astroelectronica/AE01.07.50.100/pcb/captures/AE01.07.50.100_3D_FRONT.png

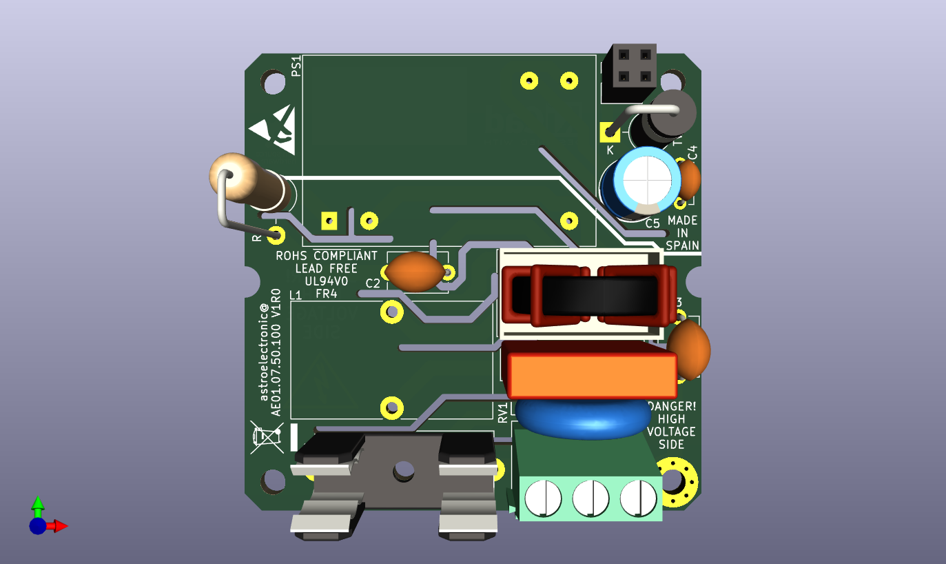
pcb/captures/AE01.07.50.100_3D_FRONT.png
