astroelectronica/AE01.07.50.100/pcb/captures/AE01.07.50.100_3D_BACK.png

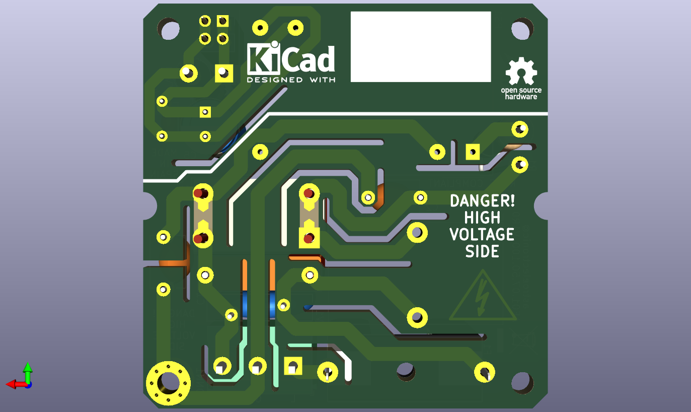
pcb/captures/AE01.07.50.100_3D_BACK.png
