astroelectronica/AE01.07.50.100/pcb/AE01.07.50.100_sch.pdf

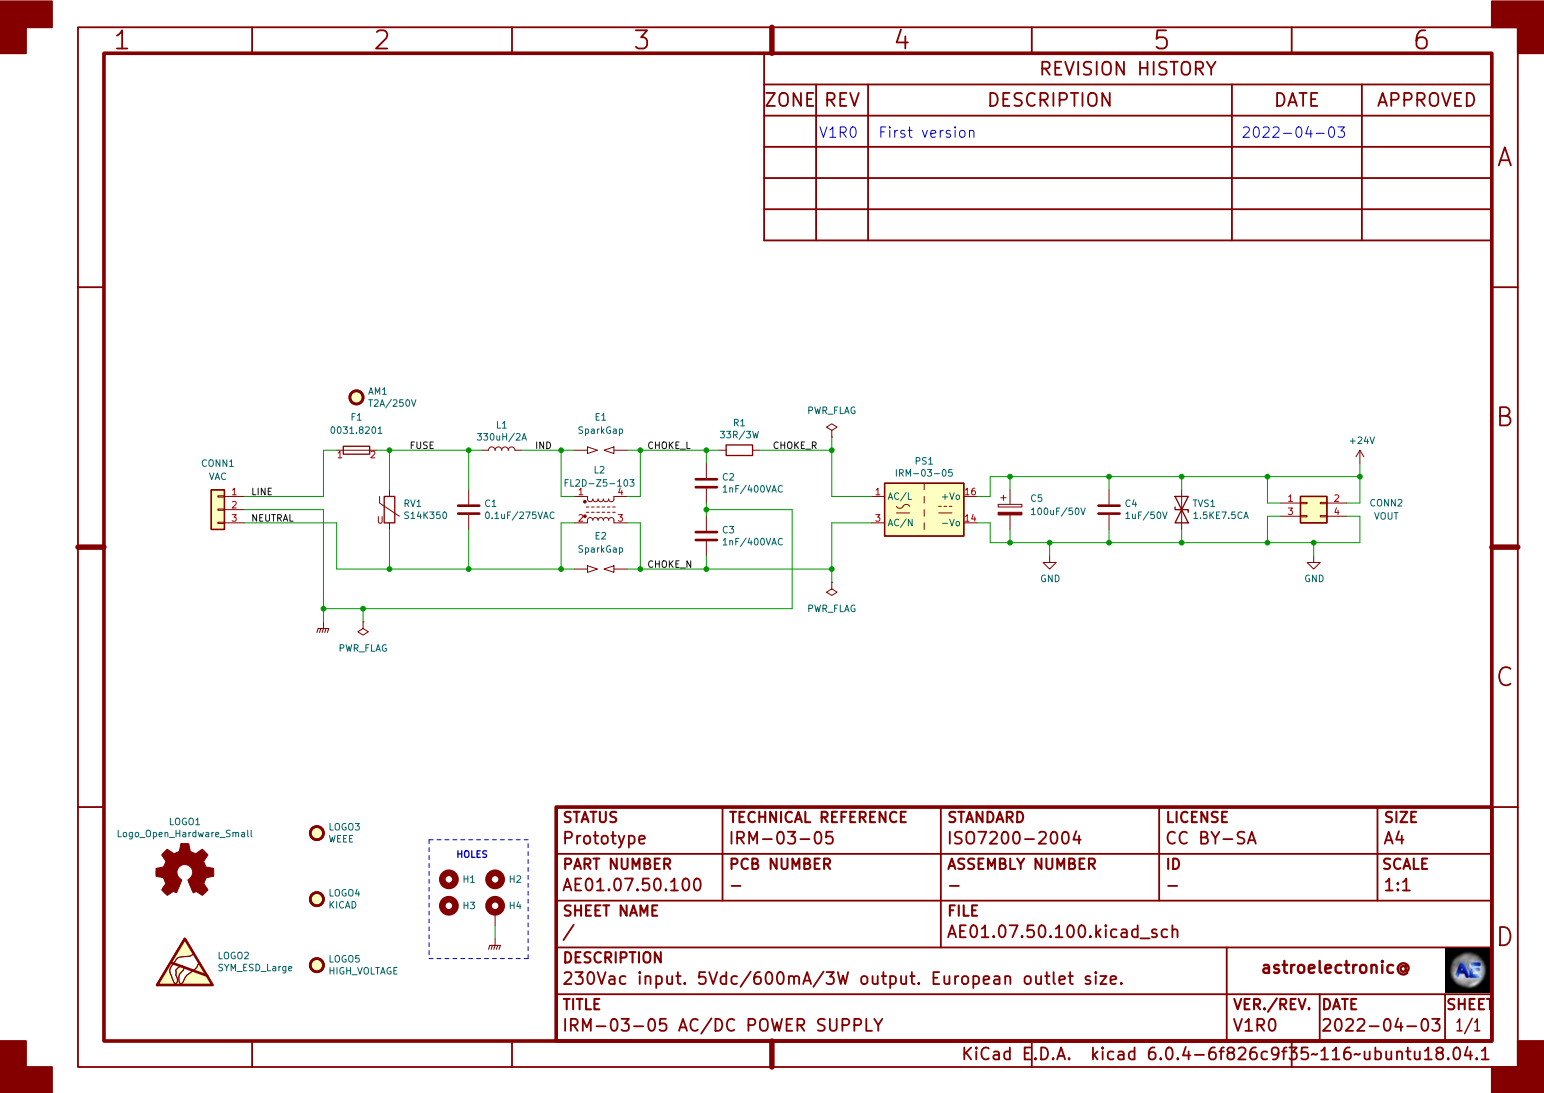
[picture p3: page 1]

Prototype | IRM-03-05 | | CC BY-SA
PART NUMBER | PCB NUMBER | ASSEMBLY NUMBER | ID | 1:1

DESCRIPTION

230Vac input. 5Vdc/600mA/3W output. European outlet size.
TITLE
IRM-03-05 AC/DC POWER SUPPLY
