astroelectronica/AE01.07.50.100/pcb/layers_pdf/AE01.07.50.100-User_Comments.pdf

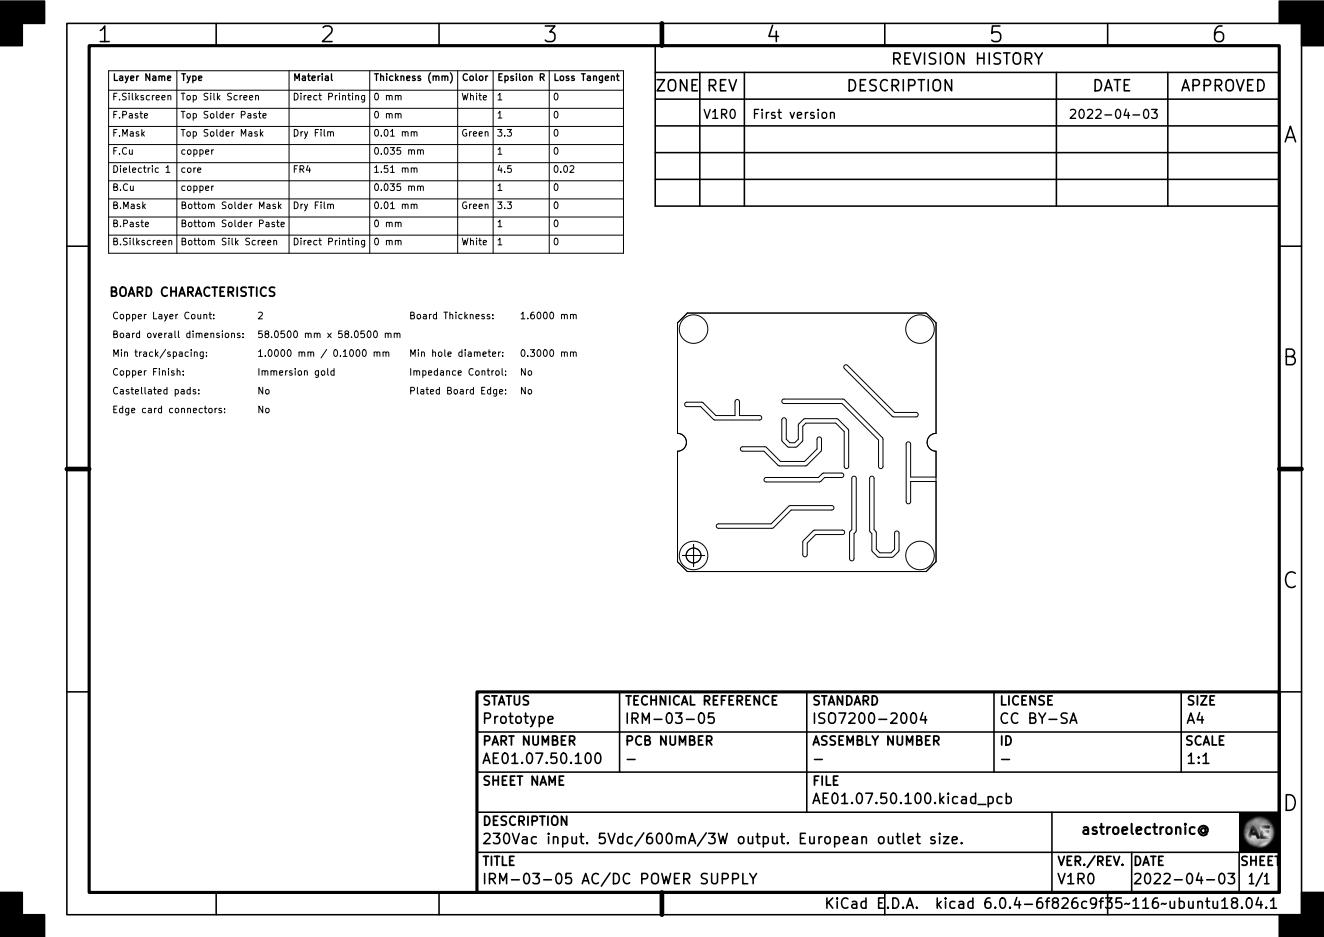
[picture p4: page 1]

0 Board overall dimensions: Type
2 F.Silkscreen BOARD CHARACTERISTICS

copper Top Solder Paste | | Material Dry Film | Thickness (mm) copper 0.01 mm | White F.Paste White Layer Name Green Green | 1 Dry Film 3.3 1 B.Mask | 0

0 mm | | 1 Top Silk Screen | 0.02 Color

core | | | 1.51 mm

Min hole diameter: 0.035 mm

0.01 mm
0 mm | 1 | 0

Prototype | IRM-03-05 | | CC BY-SA
PART NUMBER | PCB NUMBER | ASSEMBLY NUMBER | ID | 1:1

DESCRIPTION

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
