astroelectronica/AE01.07.50.100/pcb/pcb_mount/AE01.07.50.100_pcb_dim.pdf

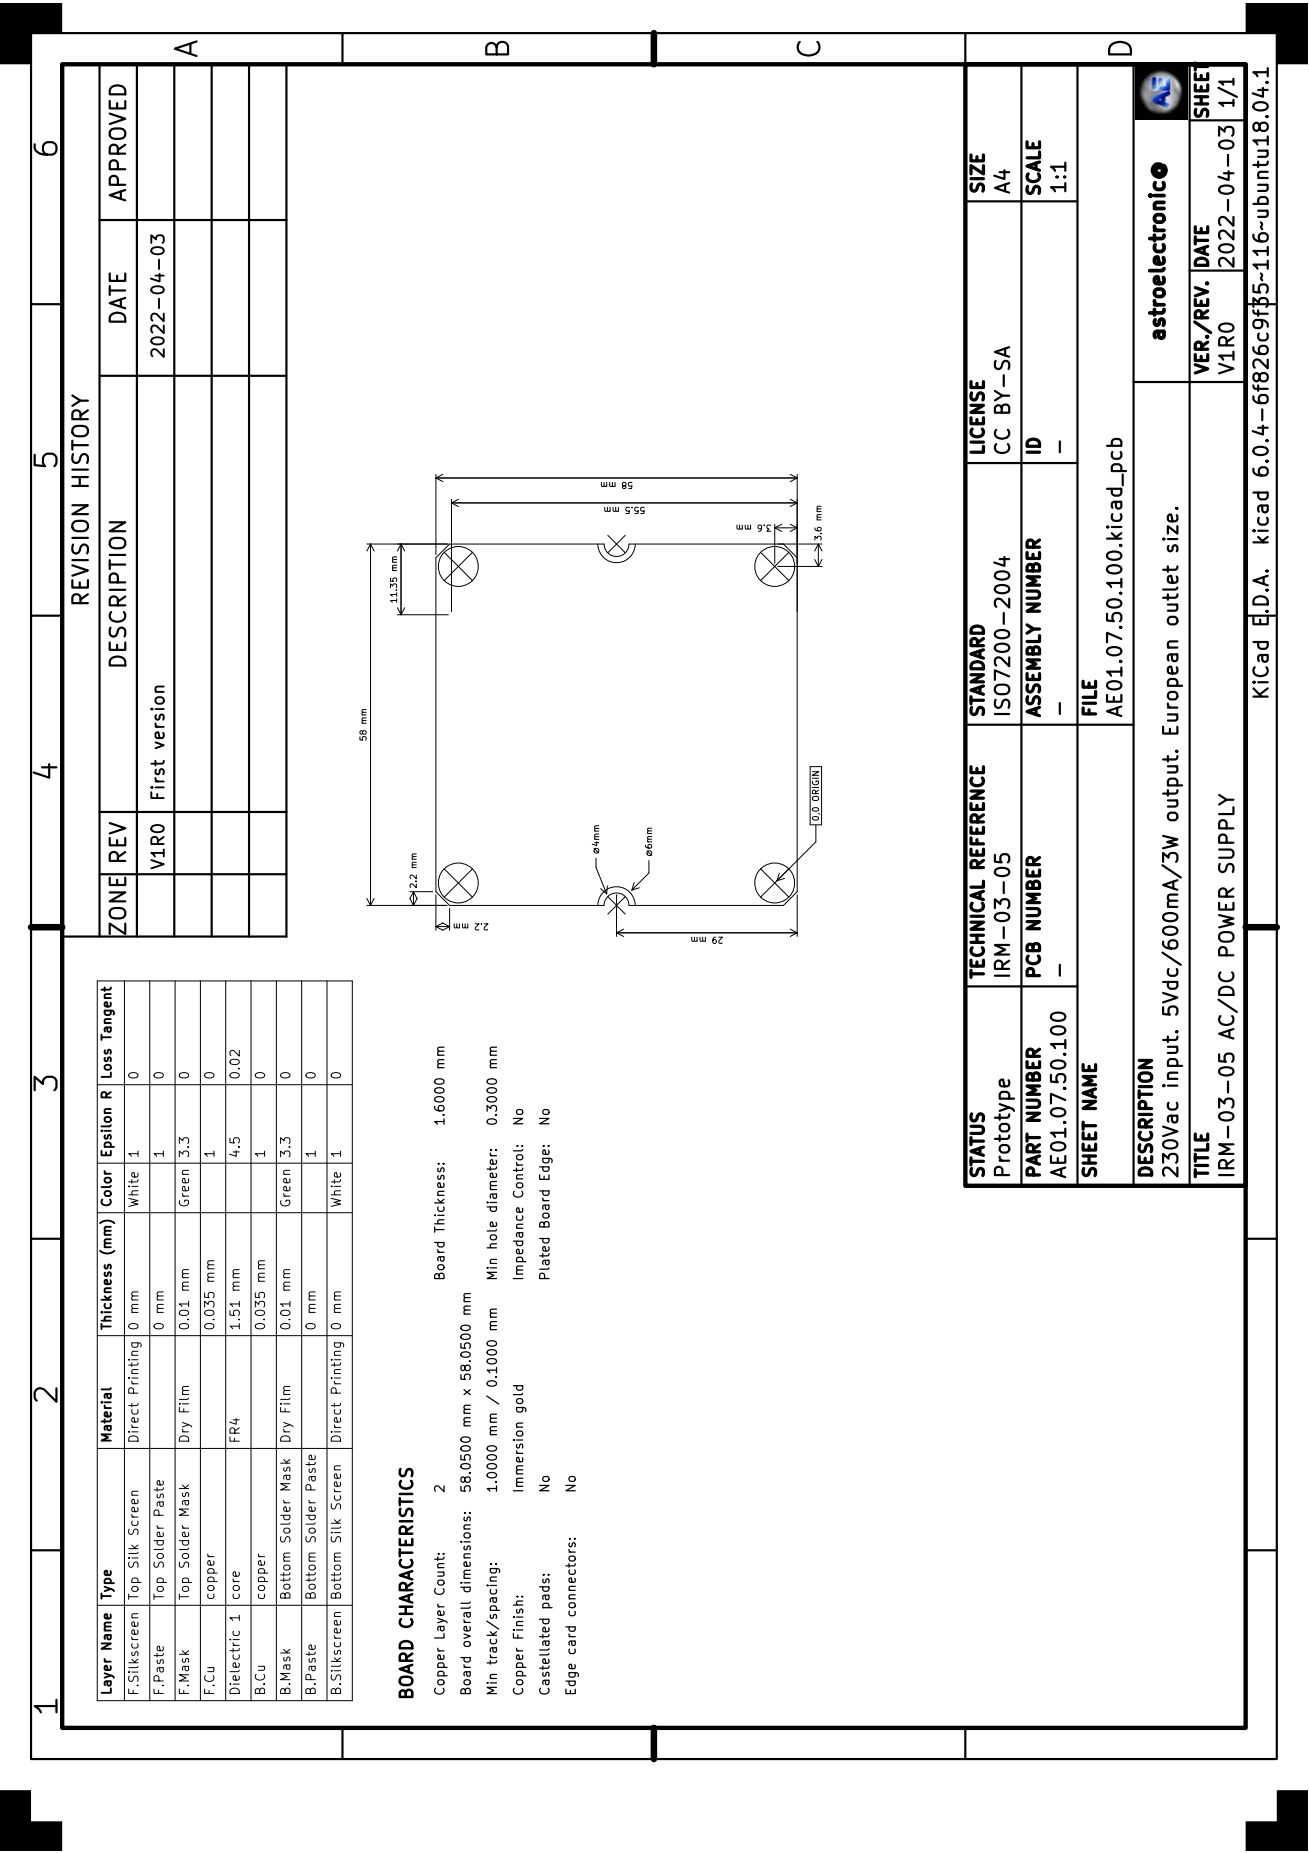
[picture p5: page 1]
