astroelectronica/AE01.07.50.100/pcb/pcb_mount/AE01.07.50.100_pcb_mount.pdf

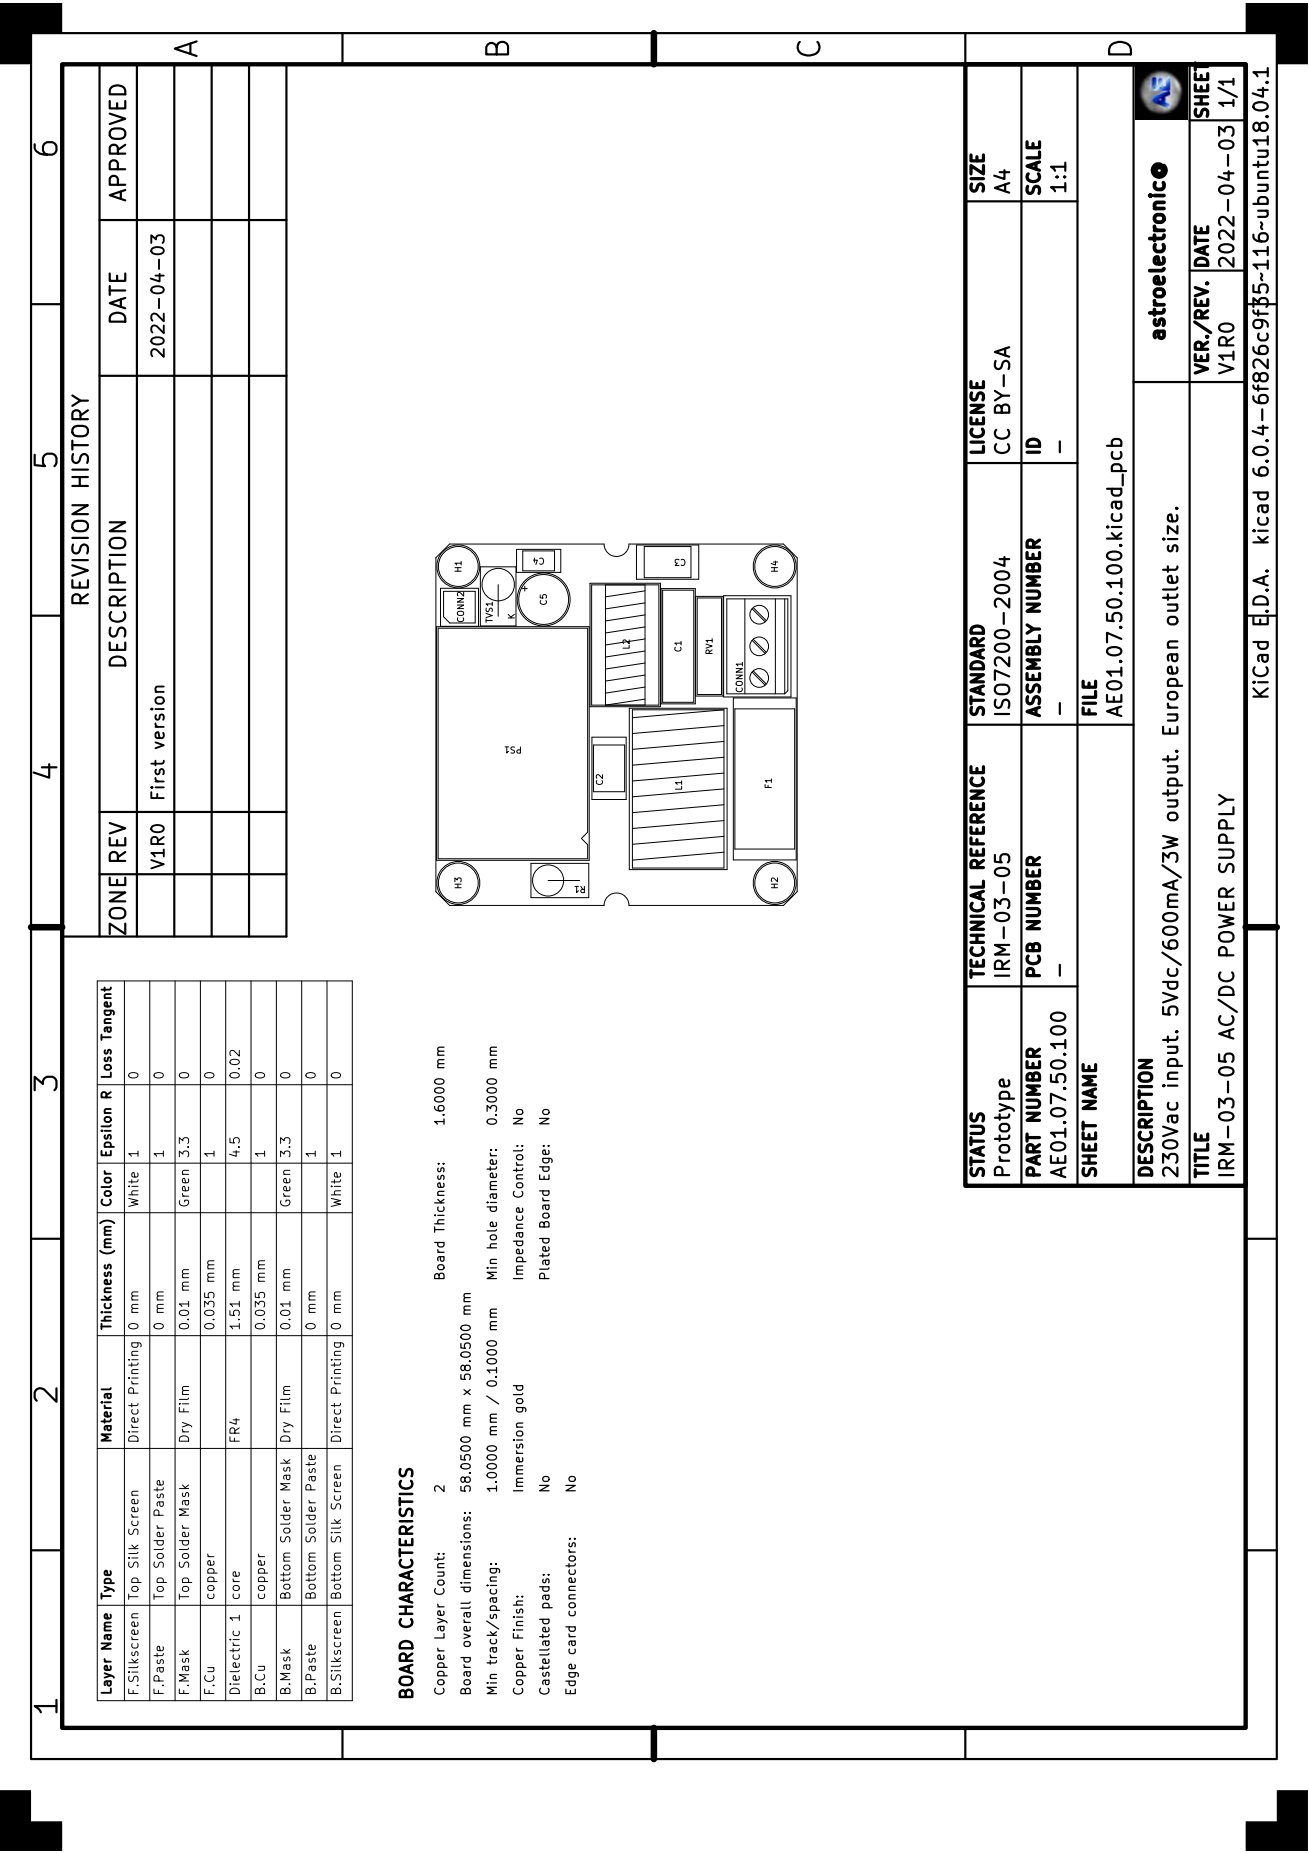
[picture p6: page 1]
