astroelectronica/AE01.07.50.100/pcb/AE01.07.50.100.kicad_pcb

## KiCad design pcb/AE01.07.50.100.kicad_pcb (2022-04-09)

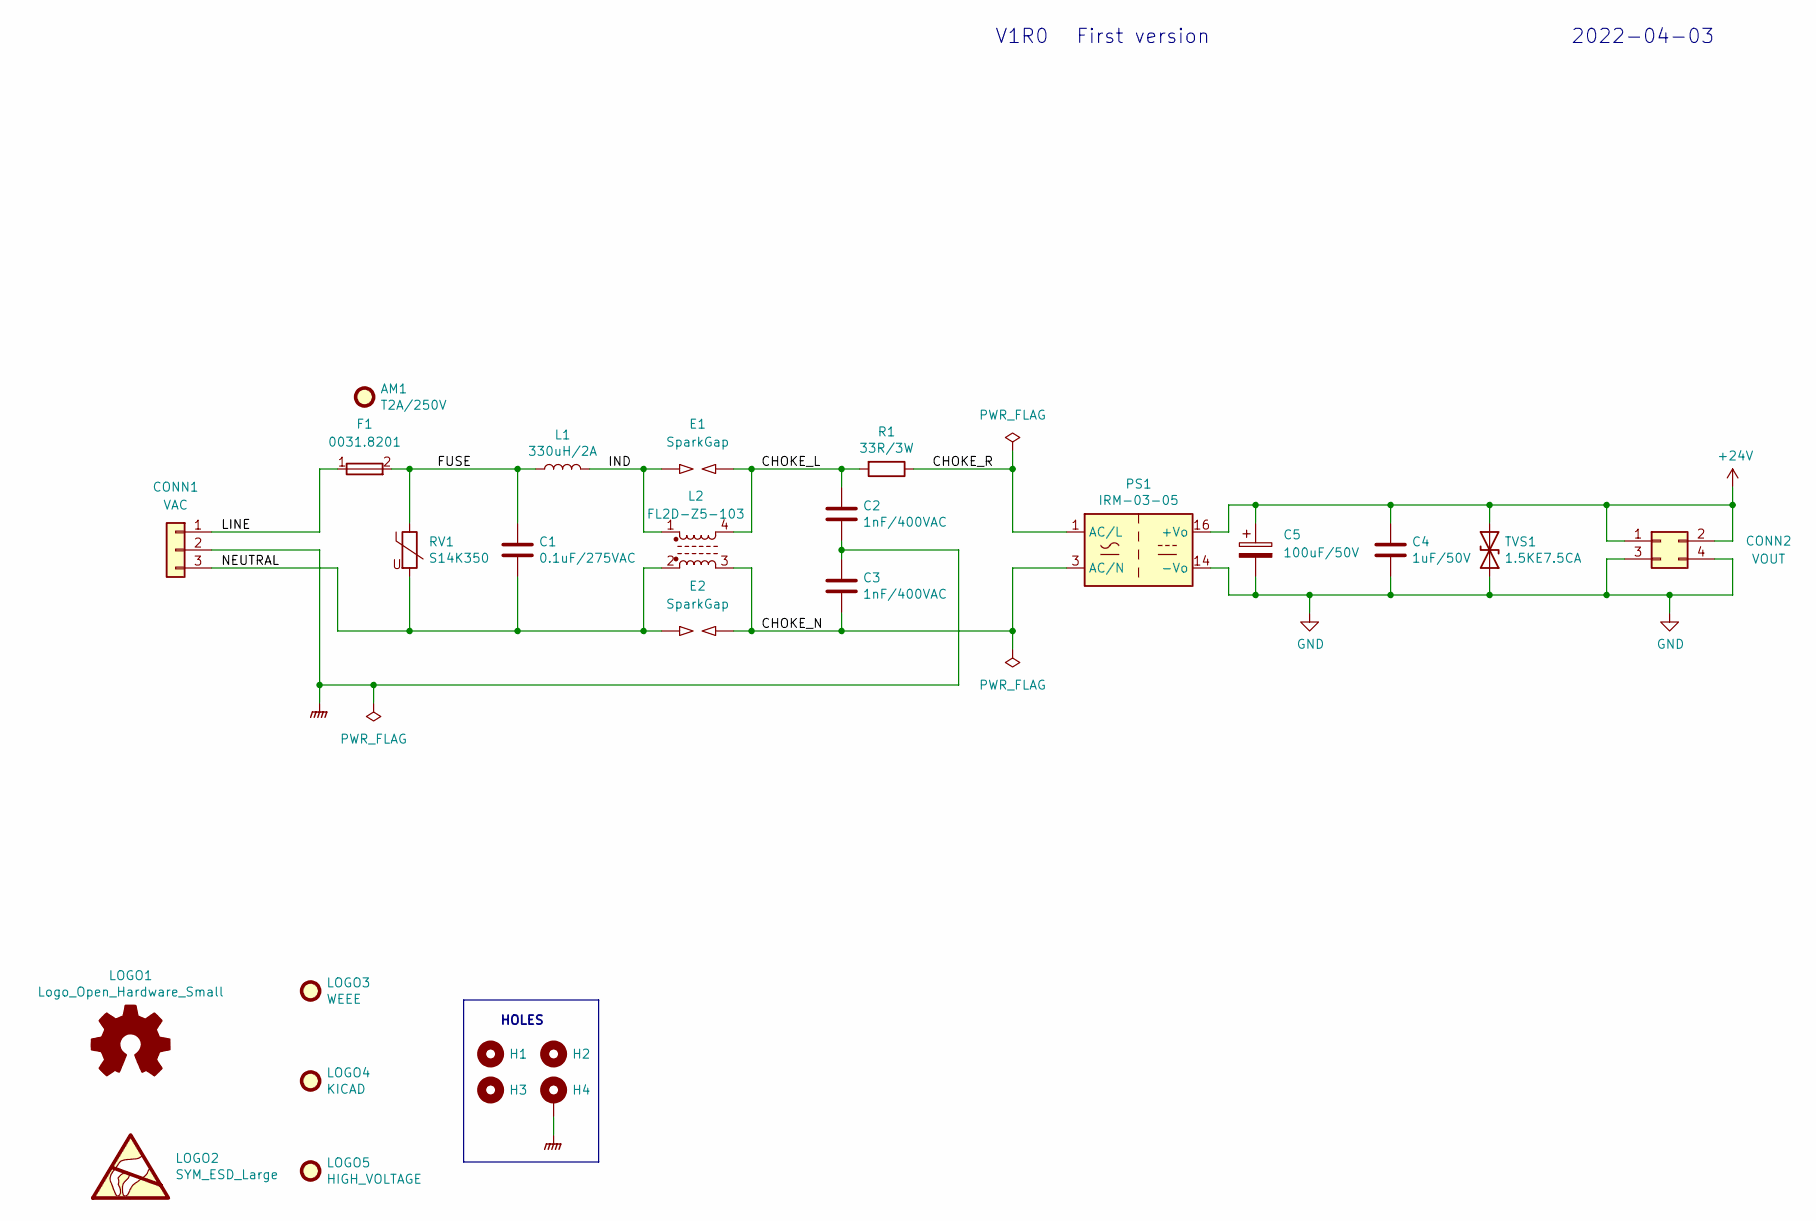
[picture p7: schematic AE01.07.50.100.kicad_sch, IRM-03-05 AC/DC POWER SUPPLY]

Parts:
AM1: T2A/250V; -; MPN 0034.3120
C1: 0.1uF/275VAC; C_Rect_L18.0mm_W5.0mm_P15.00mm_FKS3_FKP3; MPN R46KI310000M1M
C2, C3: 1nF/400VAC; C_Disc_D7.5mm_W5.0mm_P7.50mm; MPN CS65ZU2GA102MANKA
C4: 1uF/50V; C_Disc_D5.1mm_W3.2mm_P5.00mm; MPN K105M20X7RF53H5
C5: 100uF/50V; CP_Radial_D8.0mm_P3.50mm; MPN UPW1J680MPD1TD
CONN1: VAC; TerminalBlock_Phoenix_MKDS-1,5-3-5.08_1x03_P5.08mm_Horizont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; MPN 1715857
CONN2: VOUT; PinSocket_2x02_P2.54mm_Vertical; MPN BCS-101-L-D-TE
E1, E2: SparkGap; SparkGap-2_P1.3mm_OpenTrianglePad1.0x1.5mm; MPN NO_BOM
F1: 0031.8201; Fuseholder_Cylinder-5x20mm_Schurter_0031_8201_Horizontal_Op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; MPN 0031.8201
H1, H2, H3: MountingHole; MountingHole_3.2mm_M3; MPN NO_BOM
H4: MountingHole_Pad; MountingHole_3.2mm_M3_Pad_Via; MPN NO_BOM
L1: 330uH/2A; L_Toroid_Vertical_L25.4mm_W14.7mm_P12.20mm_Vishay_TJ5_BigPa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; MPN DPO-3.0-330
L2: FL2D-Z5-103; MPN FL2D-Z5-103
LOGO1: Logo_Open_Hardware_Small; OSHW-Logo_5.7x6mm_SilkScreen; MPN NO_BOM
LOGO2: SYM_ESD_Large; ESD-Logo_6.6x6mm_SilkScreen; MPN NO_BOM
LOGO3: WEEE; WEEE-Logo_4.2x6mm_SilkScreen; MPN NO_BOM
LOGO4: KICAD; KiCad-Logo2_5mm_SilkScreen; MPN NO_BOM
LOGO5: HIGH_VOLTAGE; Symbol_HighVoltage_Type2_CopperTop_VerySmall; MPN NO_BOM
PS1: IRM-03-05; Converter_ACDC_MeanWell_IRM-03-xx_THT; MPN IRM-03-05
R1: 33R/3W; R_Axial_DIN0516_L15.5mm_D5.0mm_P5.08mm_Vertical; MPN ROX3SJ33R
RV1: S14K350; RV_Disc_D15.5mm_W3.9mm_P7.5mm; MPN B72214P2351K101
TVS1: 1.5KE7.5CA; D_DO-201_P5.08mm_Vertical_KathodeUp; MPN 1.5KE7.5CA

Connections:
+24V: C4.1, C5.1, CONN2.1, CONN2.2, PS1.16 (+Vo), TVS1.1 (A1)
/CHOKE_L: C2.1, E1.2, L2.4, R1.2
/CHOKE_N: C3.2, E2.2, L2.3, PS1.3 (AC/N)
/CHOKE_R: PS1.1 (AC/L), R1.1
/FUSE: C1.1, F1.2, L1.1, RV1.1
/IND: E1.1, L1.2, L2.1
/LINE: CONN1.1, F1.1
/NEUTRAL: C1.2, CONN1.3, E2.1, L2.2, RV1.2
GND: C4.2, C5.2, CONN2.3, CONN2.4, PS1.14 (-Vo), TVS1.2 (A2)
GNDPWR: C2.2, C3.1, CONN1.2, H4.1

Notes on the sheet:
HOLES
2022-04-03
First version
V1R0

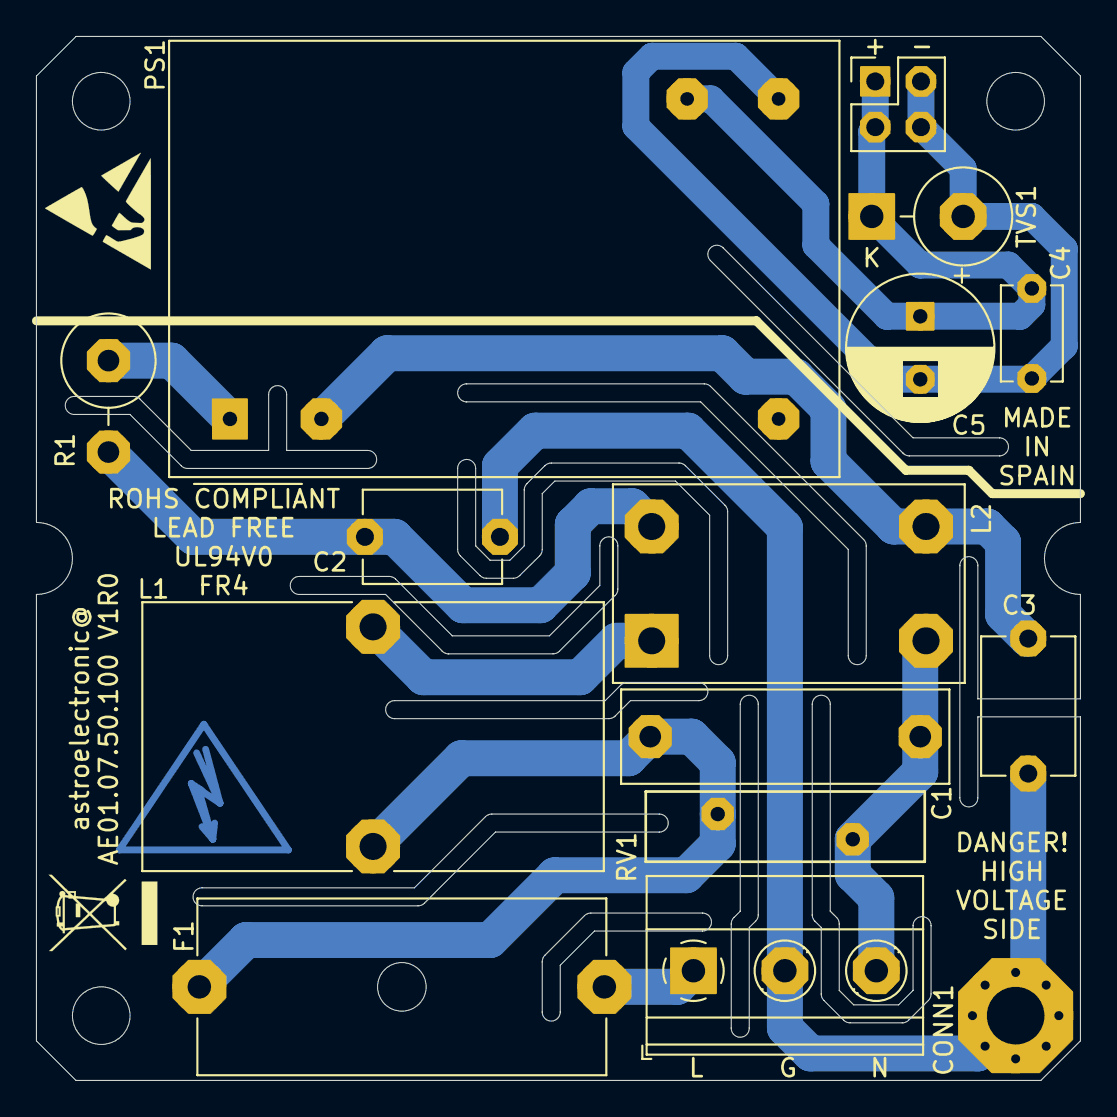
[picture p8: board AE01.07.50.100.kicad_pcb from above]

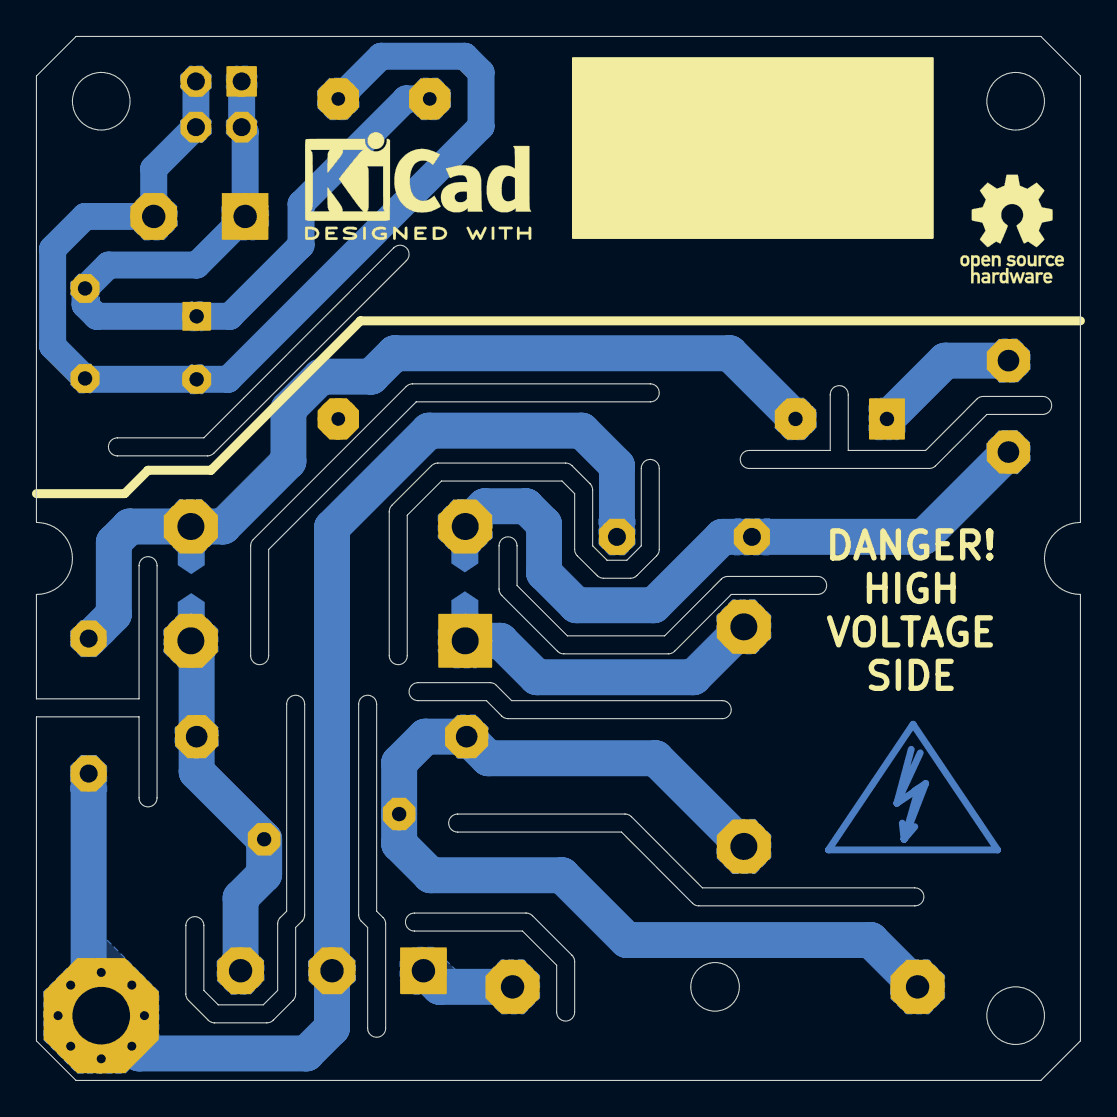
[picture p9: board AE01.07.50.100.kicad_pcb from below]

Board: 2 copper layers, 58.0 x 58.0 mm, 25 parts (5 on the bottom side), 10 nets.
